taragor/espHomeSoundBar/board/SendspinArc/SendspinArc.step

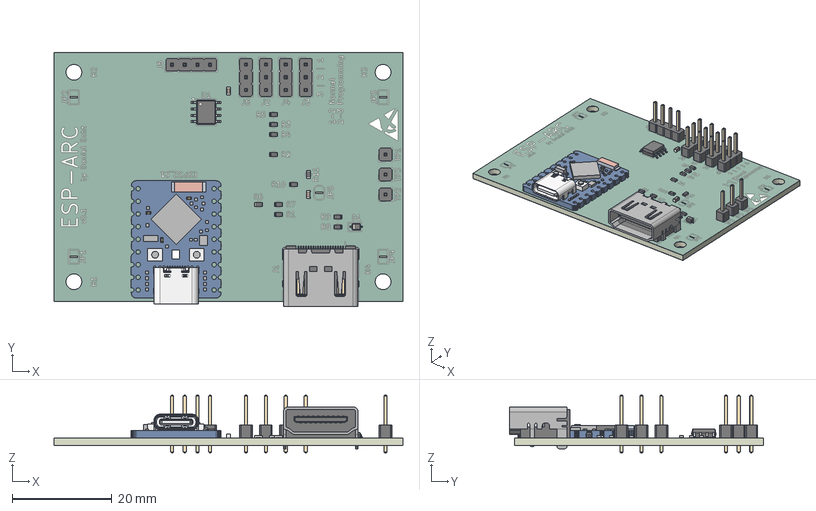
[picture p1: CAD file, 2026-11-02]
board/SendspinArc/SendspinArc.step
70.0 x 51.0 x 11.5 mm
D_SOD-323
C_0603_1608Metric x 2
PinHeader_1x01_P254mm_Vertical x 3
R_0603_1608Metric x 11
BOARD
EXTRUDED-21020 x 13
EXTRUDED-21415 x 7
3_1_A x 3
EXTRUDED-58116 x 2
EXTRUDED-58651
EXTRUDED-59046
EXTRUDED-59609
TYPE-C_16PIN-9X3X7_3
PRT0001
C3
BUTTON-2X3XH1_5
PinHeader_1x03_P254mm_Vertical x 4
SOIC-8_3.9x4.9mm_P1.27mm
PinHeader_1x04_P254mm_Vertical
HDMI_A_Molex_208658-1001_Horizontal
SenE0C0_silkscreen
SenE0C0_soldermask x 2
SenE0C0_PCB
