taragor/espHomeSoundBar/board/SendspinArc/SendspinArc.kicad_pcb

## KiCad design board/SendspinArc/SendspinArc.kicad_pcb (2026-11-02)

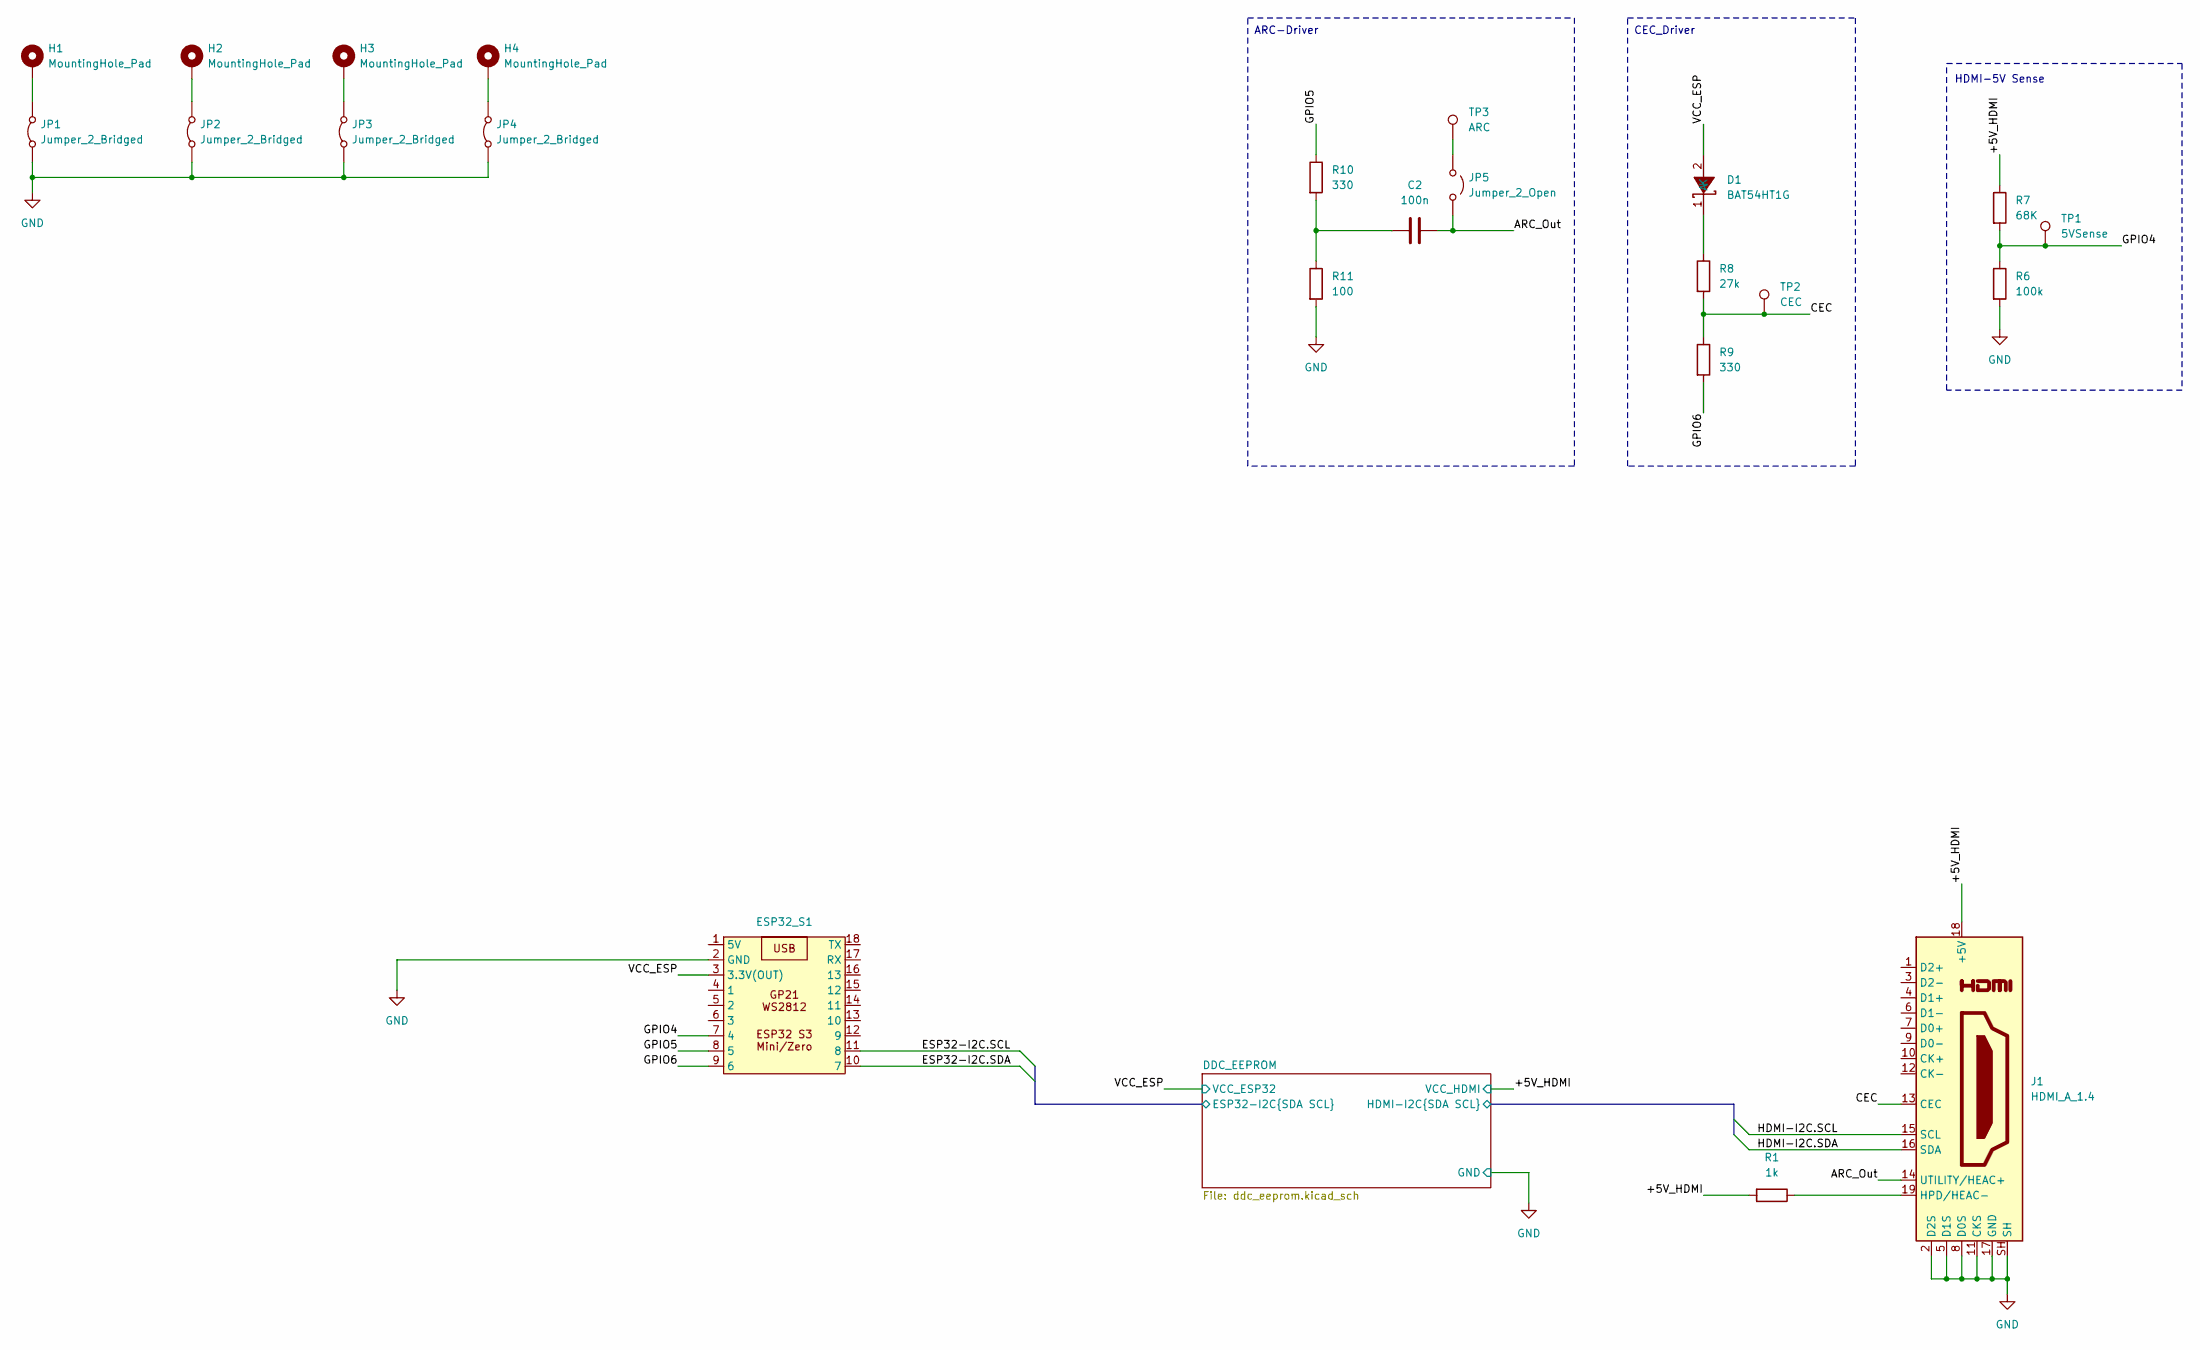
[picture p2: schematic SendspinArc.kicad_sch]

Parts:
C2: 100n; C_0603
D1: BAT54HT1G; D_SOD-323; Manufacturer Part BAT54HT1G; LCSC C21107
ESP32_S1: Waveshare_ESP32_S3_Zero_SMD
H1, H2, H3, H4: MountingHole_Pad; MountingHole_3.2mm_M3_DIN965_Pad_TopBottom
J1: HDMI_A_1.4; HDMI_A_Molex_208658-1001_Horizontal; LCSC C720616
JP1, JP2, JP3, JP4: Jumper_2_Bridged; SolderJumper-2_P1.3mm_Bridged_Pad1.0x1.5mm
JP5: Jumper_2_Open; SolderJumper-2_P1.3mm_Open_RoundedPad1.0x1.5mm
R1: 1k; R_0603_1608Metric
R6: 100k; R_0603_1608Metric
R7: 68K; R_0603_1608Metric
R8: 27k; R_0603_1608Metric
R9, R10: 330; R_0603_1608Metric
R11: 100; R_0603_1608Metric
TP1: 5VSense; PinHeader_1x01_P2.54mm_Vertical
TP2: CEC; PinHeader_1x01_P2.54mm_Vertical
TP3: ARC; PinHeader_1x01_P2.54mm_Vertical

Connections:
/+5V_HDMI: J1.18 (+5V), R1.2, R7.1; also elsewhere on the board
/ARC_Out: C2.2, J1.14 (UTILITY/HEAC+), JP5.2 (B)
/CEC: J1.13 (CEC), R8.2, R9.1, TP2.1 (1_1)
/DDC_EEPROM/ESP32-I2C.SCL: ESP32_S1.11 (8); also elsewhere on the board
/DDC_EEPROM/ESP32-I2C.SDA: ESP32_S1.10 (7); also elsewhere on the board
/DDC_EEPROM/HDMI-I2C.SCL: J1.15 (SCL); also elsewhere on the board
/DDC_EEPROM/HDMI-I2C.SDA: J1.16 (SDA); also elsewhere on the board
/GPIO4: ESP32_S1.7 (4), R6.1, R7.2, TP1.1 (1_1)
/GPIO5: ESP32_S1.8 (5), R10.1
/GPIO6: ESP32_S1.9 (6), R9.2
/VCC_ESP: D1.2 (A), ESP32_S1.3 (3.3V(OUT)); also elsewhere on the board
GND: ESP32_S1.2 (GND), J1.2 (D2S), J1.5 (D1S), J1.8 (D0S), J1.11 (CKS), J1.17 (GND), J1.SH, JP1.1 (A), JP2.1 (A), JP3.1 (A), JP4.1 (A), R6.2, R11.2; also elsewhere on the board
unnamed: C2.1, R10.2, R11.1
unnamed: D1.1 (K), R8.1
unnamed: J1.19 (HPD/HEAC-), R1.1
unnamed: H1.1 (1_1), JP1.2 (B)
unnamed: H2.1 (1_1), JP2.2 (B)
unnamed: H3.1 (1_1), JP3.2 (B)
unnamed: H4.1 (1_1), JP4.2 (B)
unnamed: JP5.1 (A), TP3.1 (1_1)

Notes on the sheet:
ARC-Driver
CEC_Driver
HDMI-5V Sense

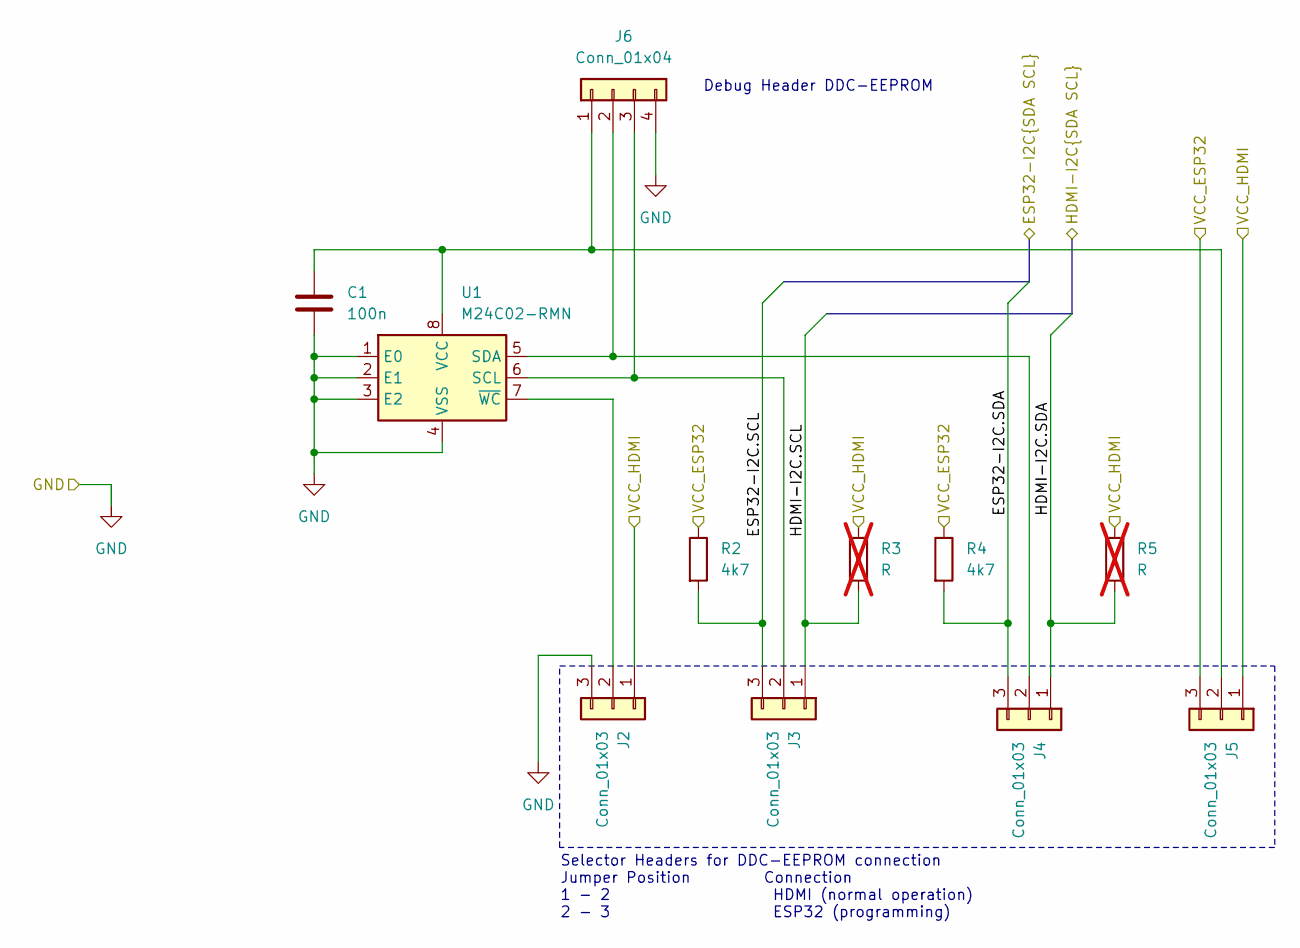
[picture p3: schematic ddc_eeprom.kicad_sch]

Parts:
C1: 100n; C_0603
J2, J3, J4, J5: Conn_01x03; PinHeader_1x03_P2.54mm_Vertical
J6: Conn_01x04; PinHeader_1x04_P2.54mm_Vertical; LCSC C160334
R2, R4: 4k7; R_0603_1608Metric
R3, R5: R; R_0603_1608Metric; not fitted
U1: M24C02-RMN; SOIC-8_3.9x4.9mm_P1.27mm; LCSC C83836

Connections:
/+5V_HDMI: J2.1, J5.1, R3.1, R5.1; also elsewhere on the board
/DDC_EEPROM/ESP32-I2C.SCL: J3.3, R2.2; also elsewhere on the board
/DDC_EEPROM/ESP32-I2C.SDA: J4.3, R4.2; also elsewhere on the board
/DDC_EEPROM/HDMI-I2C.SCL: J3.1, R3.2; also elsewhere on the board
/DDC_EEPROM/HDMI-I2C.SDA: J4.1, R5.2; also elsewhere on the board
/VCC_ESP: J5.3, R2.1, R4.1; also elsewhere on the board
GND: C1.1, J2.3, J6.4, U1.1 (E0), U1.2 (E1), U1.3 (E2), U1.4 (VSS); also elsewhere on the board
unnamed: J2.2, U1.7 (~WC)
unnamed: J3.2, J6.3, U1.6 (SCL)
unnamed: J4.2, J6.2, U1.5 (SDA)
unnamed: C1.2, J5.2, J6.1, U1.8 (VCC)

Notes on the sheet:
Selector Headers for DDC-EEPROM connection Jumper Position Connection 1 - 2 HDMI (normal operation) 2 - 3 ESP32 (programming)
Debug Header DDC-EEPROM

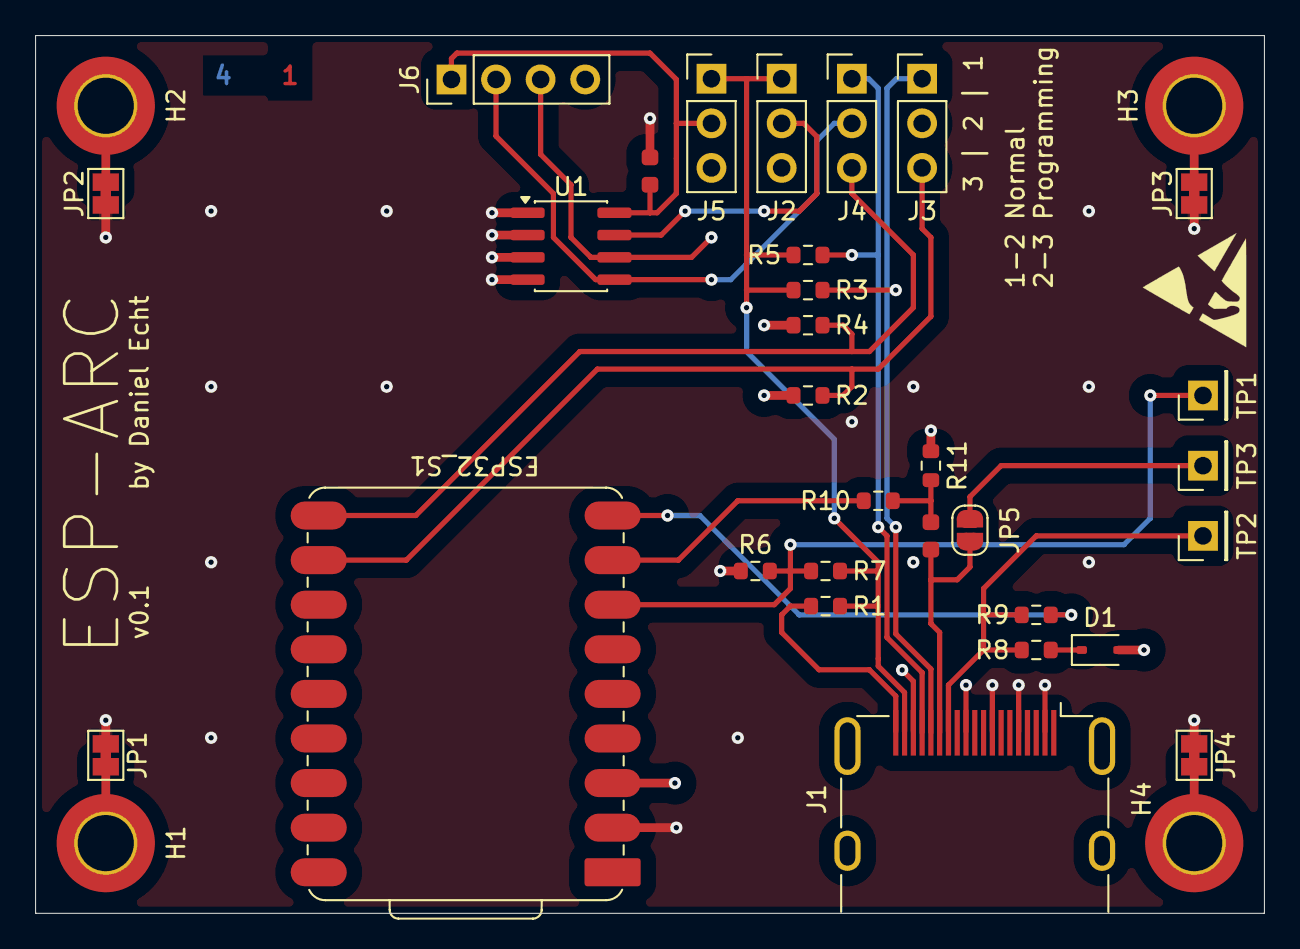
[picture p4: board SendspinArc.kicad_pcb from above]

Board: 4 copper layers, 70.0 x 50.0 mm, 35 parts (0 on the bottom side), 24 nets.

Other parts of the board:
ESD-Mark: ESD-Logo_6.6x6mm_SilkScreen
