taragor/espHomeSoundBar/(commit log)

2026-10-29 board wip
    [SendspinArc.kicad_pcb, SendspinArc.kicad_sch, bom.csv, ddc_eeprom.kicad_sch, designators.csv, positions.csv]
2026-11-02 created v0.1 of board
    [SendspinArc.kicad_pcb, SendspinArc.kicad_sch, SendspinArc.step, bom.csv, ddc_eeprom.kicad_sch, designators.csv, positions.csv]
2026-11-02 removed kicad history from git index
2026-11-02 Added initial sample config
